lordlynn/ContactMonitoring/(commit log)

2022-09-20 Free memory used to hold raw byte arrays and half organized data and bug fixes in the analysis code for pushbutton
    [Contact_Monitoring.ino, SD_Lib.cpp, SD_Lib.h]
2022-09-22 Added temperature sensor. Arduino now reserves ADC ch 15 for a TMP36. Python code now converts the BIN file correctly and reports temperature in csv output
    [Contact_Monitoring.ino]
2022-10-03 Fixed temperature decoding to include negative values
2022-10-07 Added ability to read daat back in from .csv and change the state values using digital and analog contact voltage ranges.
2022-10-07 Attempt to fix errors writing to SD. File closing triggered by the stop button now takes place in the main loop rather than in an ISR. Changed file overwrite behaviour, if a file already exists then 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
    [Contact_Monitoring.ino, SD_Lib.cpp, SD_Lib.h]
2022-11-04 Added support for temperature data from arduino. added legacy data compatability. Slight optimization to separate_data(). Added status updates to GUI through txt file. Added -f and -s options. -f acc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
2022-11-07 Added flag to separate data for the case that 0xEE appears in the binary data other than as delimiter
2022-11-22 Added a summary flag to write pipe function. If option -a is used the summary flag is true which writes 98 instead of 99 to the status file. This prevents the GUI from killing the .exe before it has 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
2022-12-07 Fixed error that would have caused temperature data to be wrong if V_SCALE changed.
    [Contact_Monitoring.ino]
